HeikoKa/Wireless-3D-Touch-Probe-Sensor/media/pics/3D-Touch-Probe_Basestation.jpg

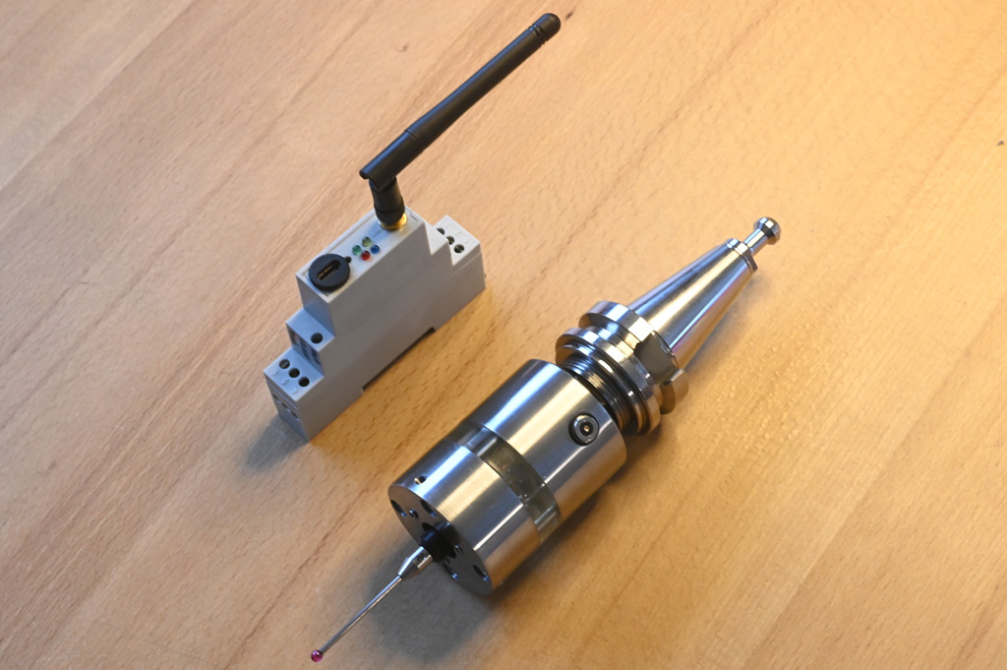
media/pics/3D-Touch-Probe_Basestation.jpg
