HeikoKa/Wireless-3D-Touch-Probe-Sensor/media/pics/3D-Touch-Probe_Loading.jpg

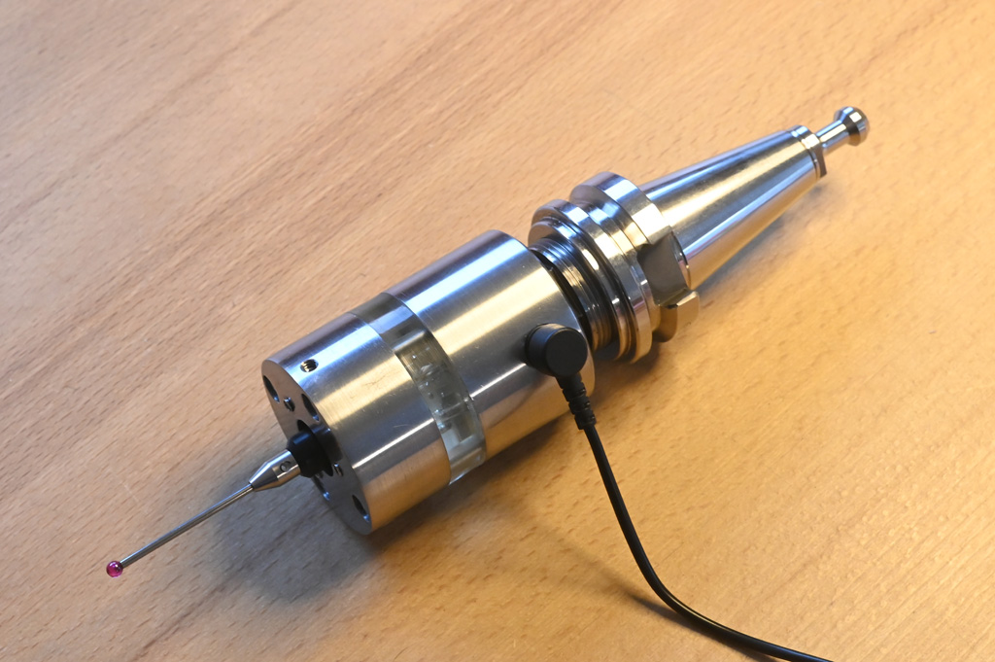
media/pics/3D-Touch-Probe_Loading.jpg
