HeikoKa/Wireless-3D-Touch-Probe-Sensor/media/pics/3D_Touch_Probe.jpg

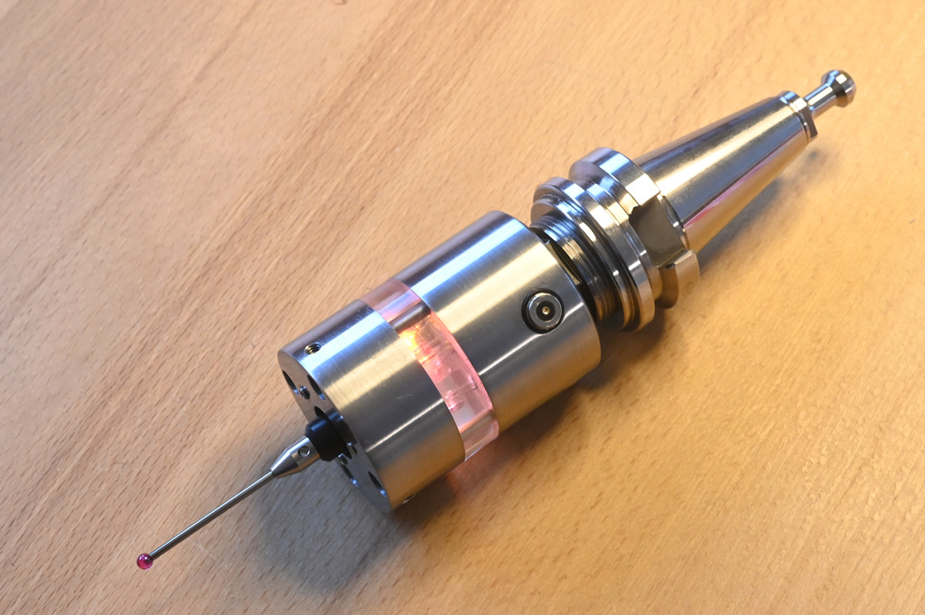
media/pics/3D_Touch_Probe.jpg
