HeikoKa/Wireless-3D-Touch-Probe-Sensor/media/pics/Basestation PCB/Basestation complete V1_0.jpg

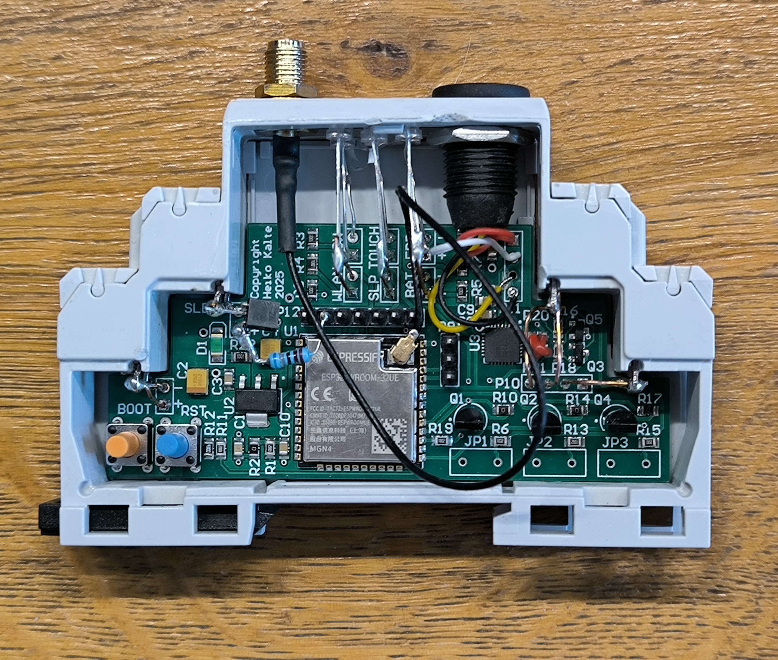
media/pics/Basestation PCB/Basestation complete V1_0.jpg
