HeikoKa/Wireless-3D-Touch-Probe-Sensor/media/pics/Basestation PCB/Basestation first Prototype.jpg

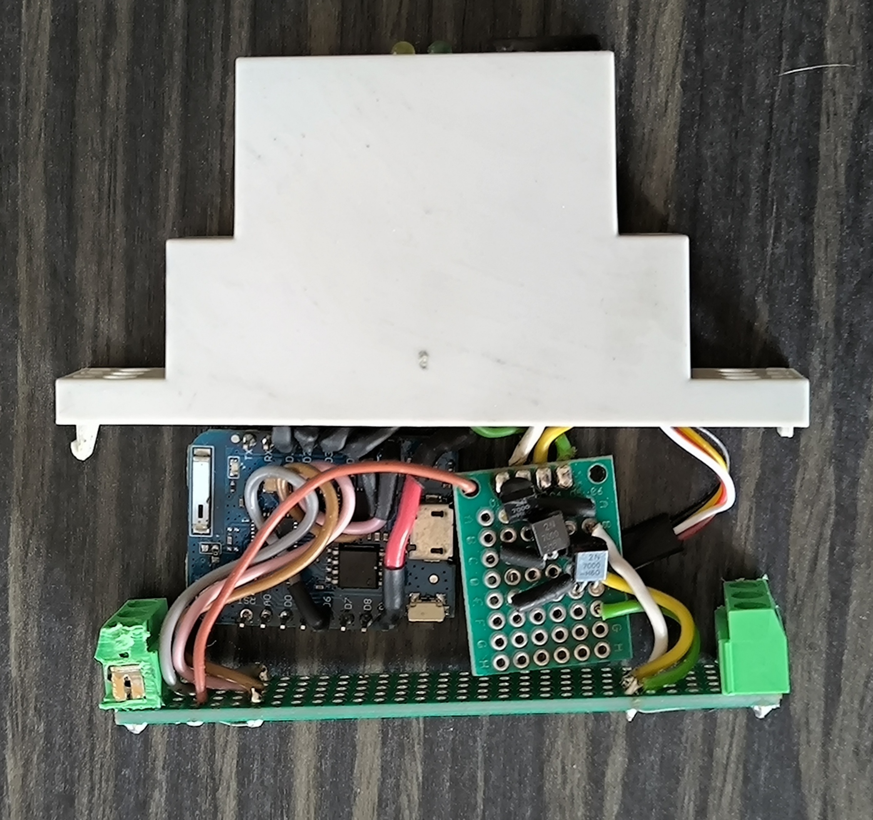
media/pics/Basestation PCB/Basestation first Prototype.jpg
