HeikoKa/Wireless-3D-Touch-Probe-Sensor/media/pics/Basestation PCB/Basestation PCB V2_0.jpg

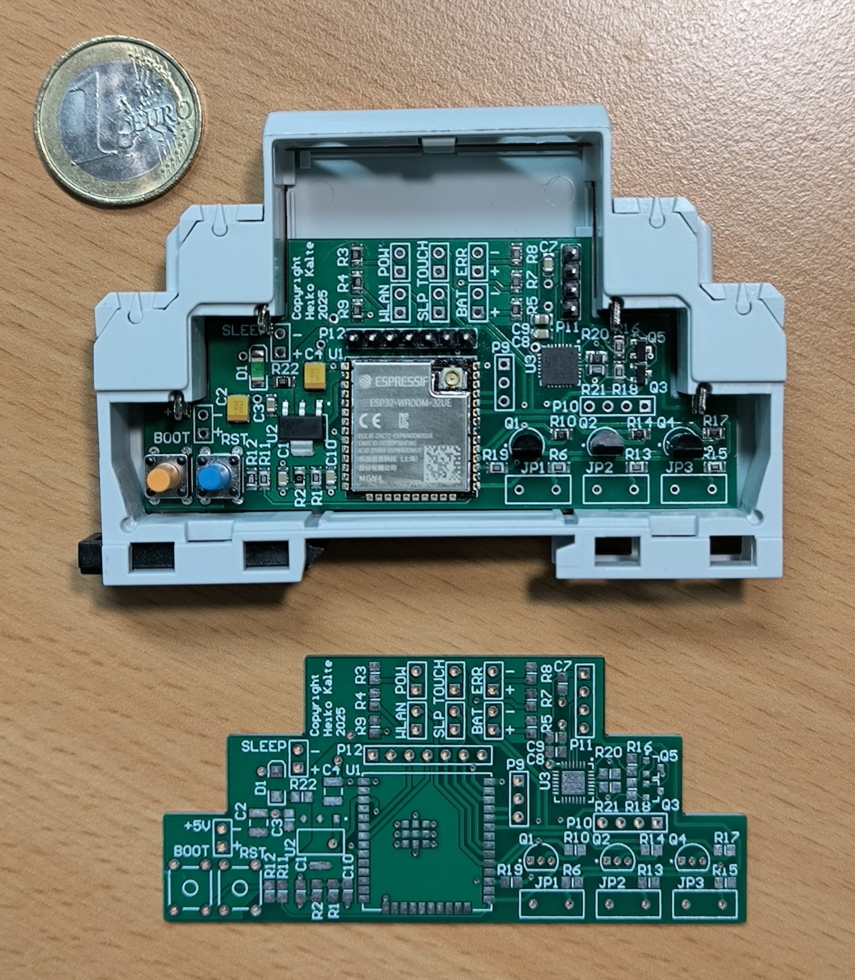
media/pics/Basestation PCB/Basestation PCB V2_0.jpg
