HeikoKa/Wireless-3D-Touch-Probe-Sensor/media/pics/Basestation.jpg

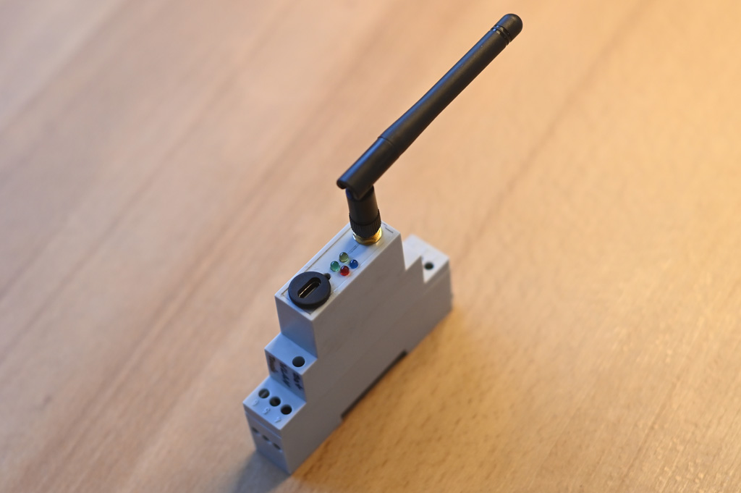
media/pics/Basestation.jpg
