HeikoKa/Wireless-3D-Touch-Probe-Sensor/media/pics/Electronics.jpg

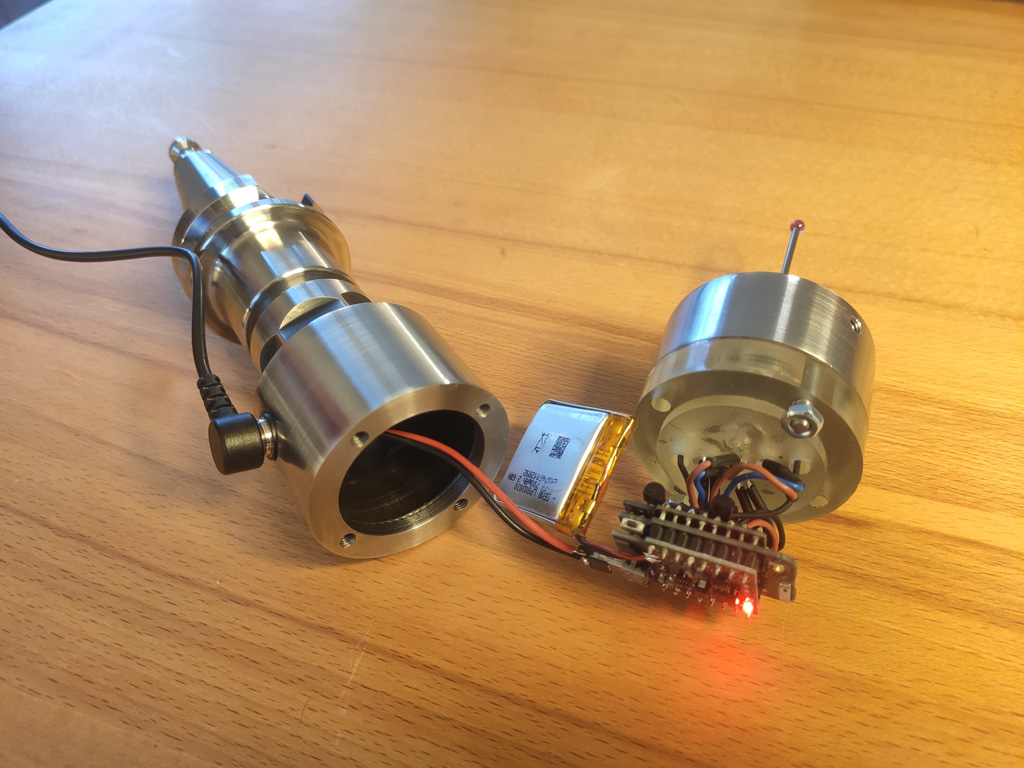
media/pics/Electronics.jpg
