HeikoKa/Wireless-3D-Touch-Probe-Sensor/media/pics/Grinding.jpg

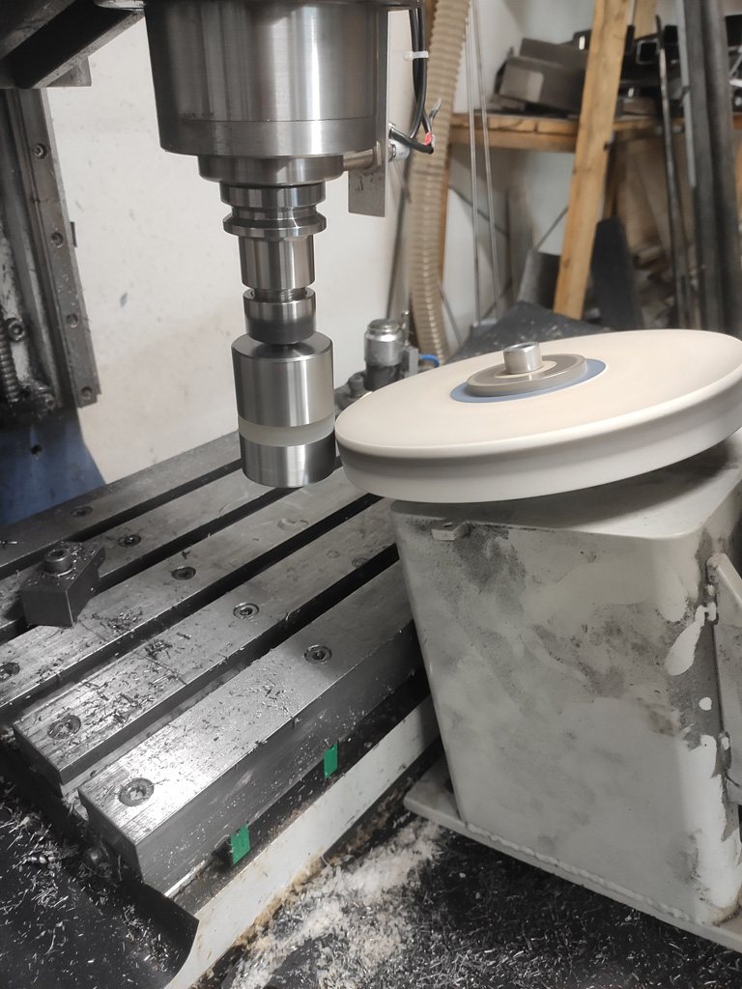
media/pics/Grinding.jpg
