HeikoKa/Wireless-3D-Touch-Probe-Sensor/media/pics/Machining_Bottom.jpg

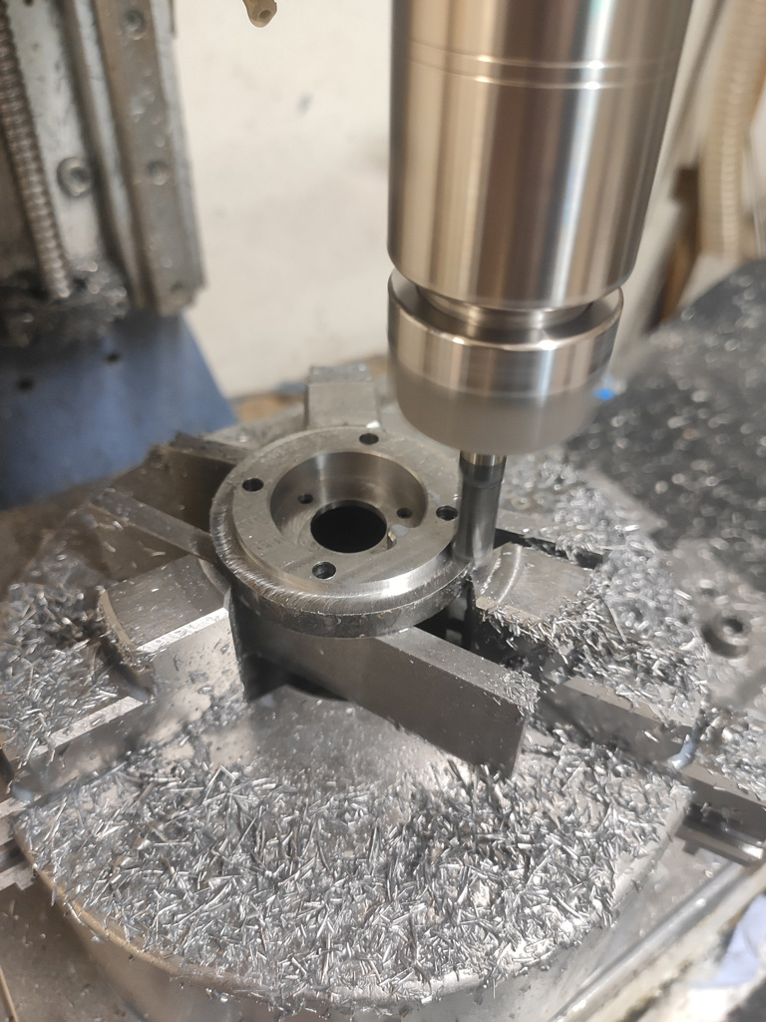
media/pics/Machining_Bottom.jpg
