HeikoKa/Wireless-3D-Touch-Probe-Sensor/media/pics/Machining_Epoxy.jpg

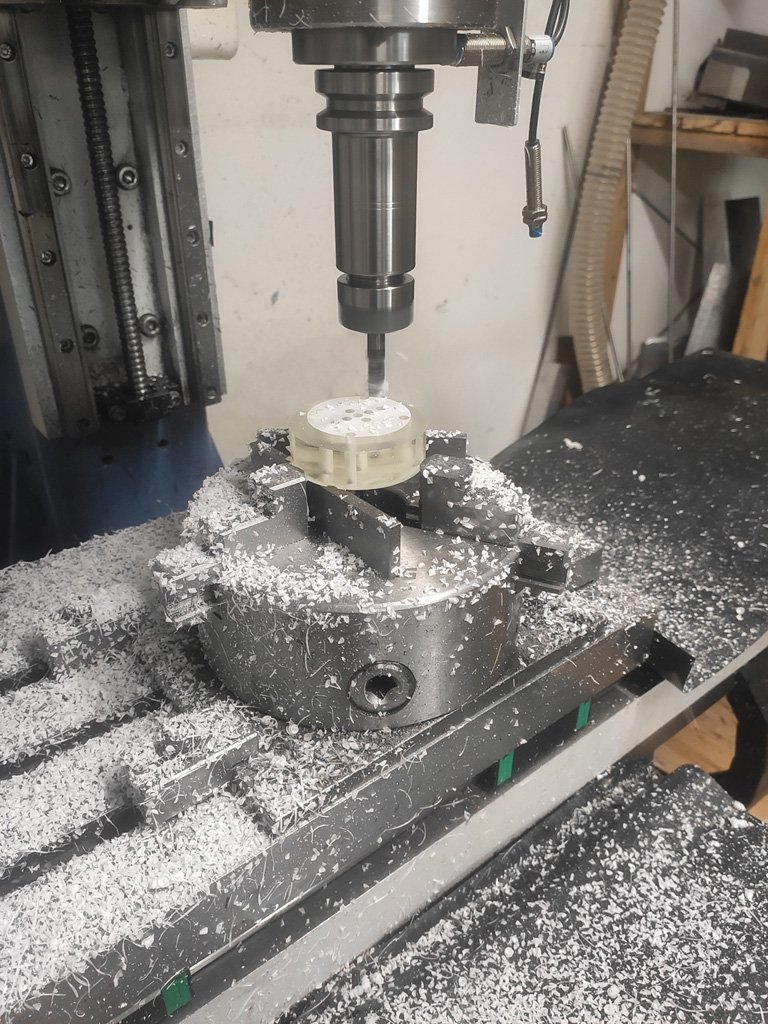
media/pics/Machining_Epoxy.jpg
