HeikoKa/Wireless-3D-Touch-Probe-Sensor/media/pics/MCU_Lipo.jpg

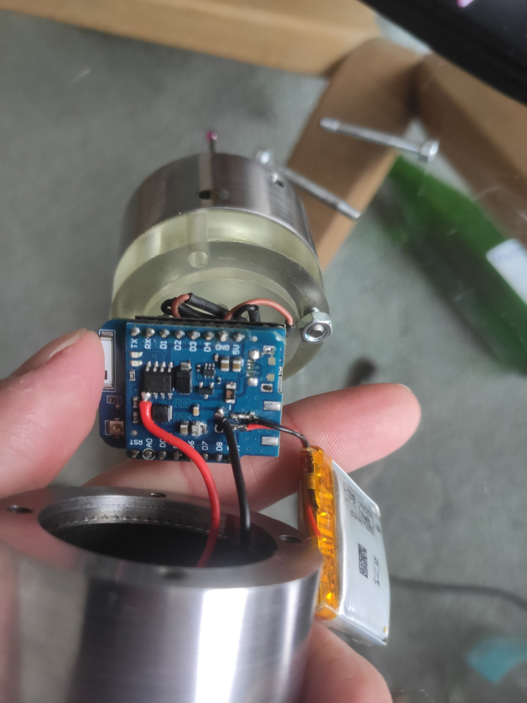
media/pics/MCU_Lipo.jpg
