HeikoKa/Wireless-3D-Touch-Probe-Sensor/media/pics/Sensor PCB/Sensor PCB V1_0 Backside Commented.jpg

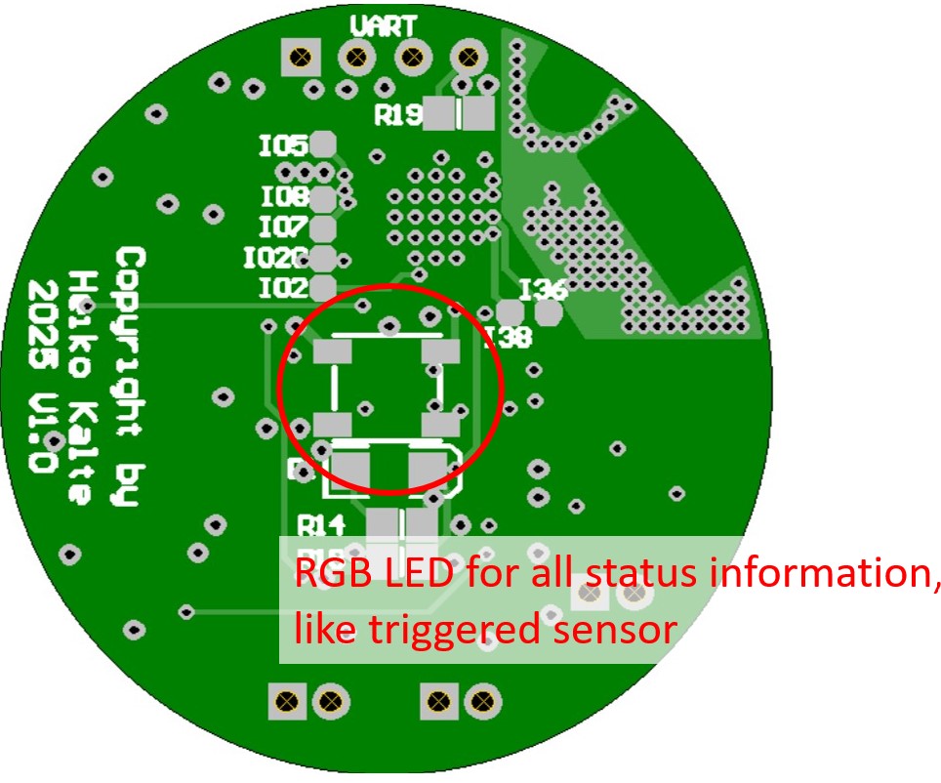
media/pics/Sensor PCB/Sensor PCB V1_0 Backside Commented.jpg
