HeikoKa/Wireless-3D-Touch-Probe-Sensor/media/pics/Transmit_Delay.jpg

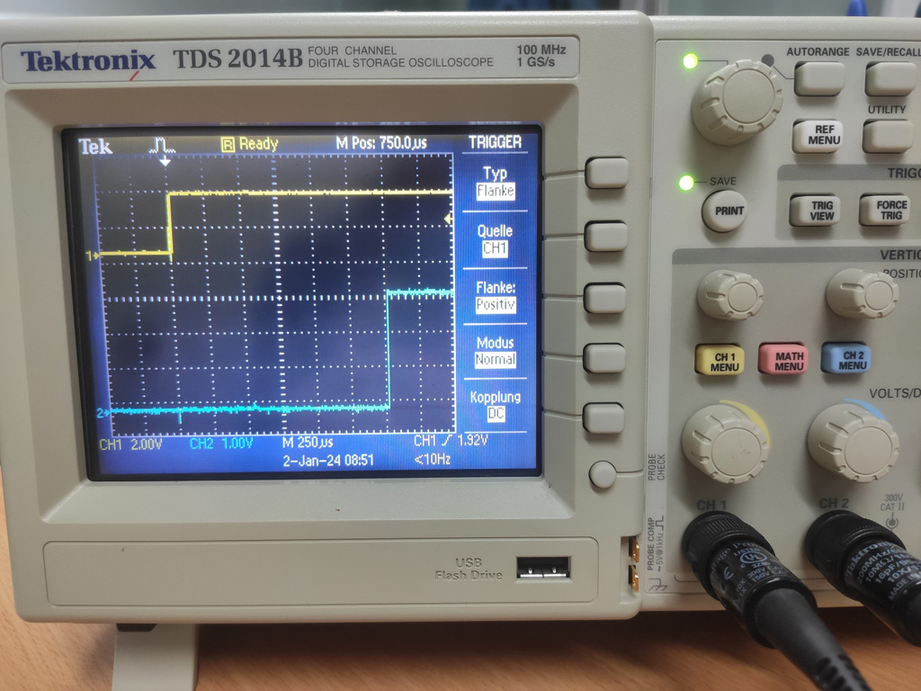
media/pics/Transmit_Delay.jpg
