HeikoKa/Wireless-3D-Touch-Probe-Sensor/media/pics/Webserver.jpg

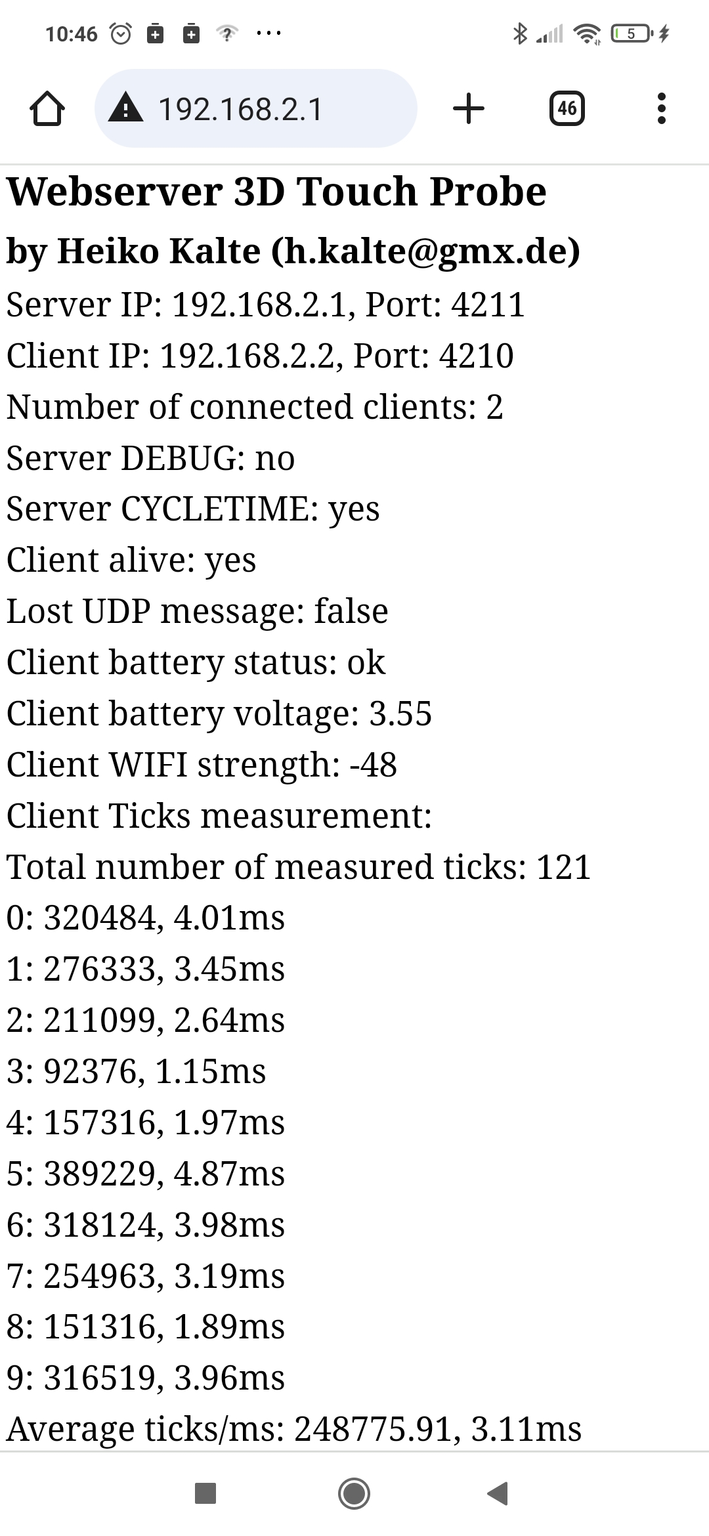
media/pics/Webserver.jpg
