HeikoKa/Wireless-3D-Touch-Probe-Sensor/src/3D-Header.h

/**  Header
  *   
  *  @author Heiko Kalte  
  *  @date 26.05.2025 
  * 
  *  @version 1.0.2
  */


//TODOs
//is NANOSEC_PER_TICK for ESP32 correct


#ifndef CNCSENSOR_H_
#define CNCSENSOR_H_

//## user defines start ##
//general defines
#define DEBUG                           // enable debug output via serial interface on client and server
#define DEBUG_SHOW_MEM_CPU_STATS         // show memory and cpu statistics
//#define VERBOSE                       // enable detailed debug Infos, only relevant with debug
//#define DEBUG_SHOW_CORE               // additional debug info on which cpu core the current function is running
//#define DEBUG_SHOW_ALL_TRANSMISSIONS  // show all wifi transmissions during DEBUG
//#define CYCLETIME                     // enable measuring the round trip delay from client to server back to client

// server/basestation specific defines
#define SERVER_HW_REVISION_3_0          // set this define if basestation/server is hardware revision 3.0 or later
#define WEBSERVER                     // enable webserver

// client specific defines
#define CLIENT_HW_REVISION_2_0          // set this define if client is hardware PCB revision 2.0 or later
//#define SHOW_STATE_COLORS             // if enabled at the startup of the client all state colors are shown one after the other
//## user defines end ##

#include "IPAddress.h"

namespace CncSensor{

  //RGB Colors                                //red                    , green                  , blue
  #define           POWER_COLOR                 CLIENT_RGB_BRIGHTNESS  , CLIENT_RGB_BRIGHTNESS  , CLIENT_RGB_BRIGHTNESS    //white  (255, 255, 255)
  #define           CHARGE_COLOR                0                      , CLIENT_RGB_BRIGHTNESS  , 0                        //green  (0  , 255,   0)
  #define           TOUCH_COLOR                 0                      , 0                      , CLIENT_RGB_BRIGHTNESS    //blue   (0  ,   0, 255)
  #define           WLAN_COLOR                  CLIENT_RGB_BRIGHTNESS  , CLIENT_RGB_BRIGHTNESS  , CLIENT_RGB_BRIGHTNESS    //white  (255, 255, 255)
  #define           RSSI_ERROR_COLOR            CLIENT_RGB_BRIGHTNESS  , 0                      , CLIENT_RGB_BRIGHTNESS    //magenta(255,   0, 255)
  #define           BATTERY_ERROR_COLOR         CLIENT_RGB_BRIGHTNESS  , 0                      , 0                        //red    (255,   0,   0)
  #define           WIFI_ERROR_COLOR            CLIENT_RGB_BRIGHTNESS  , CLIENT_RGB_BRIGHTNESS  , 0                        //yellow (255, 255,   0)
  #define           ALIVE_ERRROR_COLOR          CLIENT_RGB_BRIGHTNESS  , CLIENT_RGB_BRIGHTNESS/2, 0                        //orange (255, 127,   0)

  //datatypes
  enum fadingType  {NONE, UP, DOWN};
  
  //Version type def
  struct versionType{
    char  * swVersionString          = NULL;                  // Sw version as a string
    uint8_t mayorHwVersion           = 0;                     // mayor hardware PCB version
    uint8_t mayorSwVersion           = 0;                     // mayor software version
    uint8_t minorSwVersion           = 0;                     // minor software version
    uint8_t maintSwVersion           = 0;                     // maintenance software version
    bool    versionOk                = false;                 // is hardware mayor version at least the same as software mayor version
  };

  //general consts
  const int          BAUD_RATE                   = 9600;                  // Baud rate for serial outputs/debug
  const char*        SSID                        = "3D-Touch-WIFI";       // WLAN network name to search for when connecting to the webserver
  const char*        password                    = "123456789";           // WLAN password

  //server consts
  const char*        SERVER_SLEEP_MSG            = "sleep";               // UDP message from server to client to send client asleep
  const char*        SERVER_HELLO_MSG            = "hello";               // UDP message from server to client to say hello
  const char*        SERVER_REPLY_MSG            = "reply";               // UDP message from server to client to reply to hello msg
  const char*        SERVER_ALIVE_MSG            = "alive";               // UDP message from server to show server is alive  
  const int          CLIENT_ALIVE_CNT_MAX        = 2;                     // maximum client alive counter value
  const long         WIFI_RSSI_REPORT_LEVEL      = -85;                   // RSSI level, WLAN signal strength e.g. -40 is better -70 is worse (best was ~-30)
  const int          SERVER_TICKS_ARRAY_SIZE     = 10;                    // Array Size of measured ticks
  const bool         SERVER_SLEEP_IN_POLARITY    = true;                  // Invert SLEEP Input polarity. False means high input send sensor aleep. Truee means low input send sensor aleep (be aware that the input is inverted by a transistor, behaviour will be inverted without an external transistor)
  const bool         SERVER_WLAN_OUT_POLARITY    = true;                  // (works only with server PCB version 3 or later) invert polarity of WLAN output, false means high represents active output, true inverts output and low is active
  const bool         SERVER_TOUCH_OUT_POLARITY   = true;                  // (works only with server PCB version 3 or later) invert polarity of TOUCH output, false means high represents active output, true inverts output and low is active
  const bool         SERVER_ERROR_OUT_POLARITY   = true;                  // (works only with server PCB version 3 or later) invert polarity of ERROR output, false means high represents active output, true inverts output and low is active
  const bool         SERVER_BAT_ALM_OUT_POLARITY = true;                  // (works only with server PCB version 3 or later) invert polarity of BAT ALARM output, false means high represents active output, true inverts output and low is active
  const float        NANOSEC_PER_TICK            = 12.5;                  // ## Attention this value has not been verified for the ESP32 ##

  //client consts
  const char*        CLIENT_HELLO_MSG        = "hello";                   // UDP message from client to server to say hello
  const char*        CLIENT_REPLY_MSG        = "reply";                   // UDP message from client to server to reply to hello msg
  const char*        CLIENT_TOUCH_HIGH_MSG   = "high";                    // UDP message from client if 3D touch probe is high
  const char*        CLIENT_TOUCH_LOW_MSG    = "low";                     // UDP message from client if 3D touch probe is low
  const char*        CLIENT_ALIVE_MSG        = "alive";                   // UDP message from client alive
  const char*        CLIENT_RSSI_MSG         = "rssi";                    // UDP message from client with rssi (WLAN signal strength)
  const char*        CLIENT_CYCLE_MSG        = "CYC:";                    // UDP message from client to server to transmit the last measured cycle time ticks
  const char*        CLIENT_INFO_MSG         = "INFO:";                   // UDP message from client to server with infos about the client
  const int          SERVER_AQUN_CNT_MAX     = 25000;                     // number of loop cycles before the server must acknowledge the high/low messages
  const int          TOUCH_PIN_DEBOUNCE      = 700;                       // debounce time in µs for software touch input pin
  const uint8_t      CLIENT_RGB_BRIGHTNESS   = 20;                        // brightness of the RGB LED (max 255). Product of CLIENT_RGB_BRIGHTNESS x RGB_FADE_SPEED = Fading Time at start and end
  const bool         CLIENT_TOUCH_POLARITY   = true;                      // invert sensor touch input 
  const uint8_t      TRANSMISSION_RETRY_MAX  = 3;                         // maximum wifi transmission retrys before an transmission error is reported
  //client sleep and awake consts
  const bool         NO_SLEEP_WHILE_CHARGING = false;                     // prevent sleeping during battery loading, e.g. to keep status LED on to see is charging finished. SLEEP_DURING_CHARGING mut not be true at the same time
  const bool         SLEEP_DURING_CHARGING   = false;                     // fall asleep when charging voltage is applied (need not necessary charging), helpfull e.g. in case of a charger in the toolchanger magazine. NO_SLEEP_WHILE_CHARGING must not be true at the same time
  const bool         AUTO_SLEEP_TIMER_ENABLE = false;                     // enables/disables a timeout counter that sends the client asleep after a certain period of time of no touching (see also SLEEP_NO_TOUCH_CYCLES)
  const int          AUTO_SLEEP_TIMER_CYCLES = 30;                        // timeout service cycles to send the client asleep after no touching event (timeout function must be enabled by SLEEP_NO_TOUCH_TIMEOUT, has also a relationship to parameter SERVICE_INTERVALL)
  const int          SERVER_ALIVE_CNT_MAX    = 2;                         // maximum server alive counter value, try to reconnect
  const int          SERVER_ALIVE_CNT_DEAD   = 3;                         // maximum server alive counter value, server seems to be dead and go to sleep
  const bool         CLIENT_ALLOW_LED_FADING = true;                      // allow fading LED at startup and sleep. Leads to longer startup time, but looks nice.
  const uint8_t      CLIENT_RGB_FADE_SPEED   = 100;                       // speed for fading out the LED brightness when going to sleep. Set as delay, smaller value faster fading
  
  //client and server consts
  const uint32_t     SERVICE_INTERVALL_ESP32 = 15000000;                  // ESP32 Time in 1MHz ticks between service interrupt calls (20000000 = 20sec)
  const int          UDP_PACKET_MAX_SIZE     = 128;                       // UDP buffer size
  const uint8_t      SLOW_BLINK              = 1000;                      // delay for slow blinking LED
  const uint8_t      FAST_BLINK              = 500;                       // delay for fast blinking LED
  const uint8_t      WLAN_INIT_PAUSE         = 100;                       // Pause length during WLAN initiation

  //IP addresses
  IPAddress         serverIpAddr(192,168,  2,1);                          // local IP address of server and webserver ip address if enabled
  IPAddress         clientIpAddr(192,168,  2,2);                          // local IP address of client
  IPAddress         gateway     (192,168,  2,0);                          // gateway of server, need to have a value, but does not exist
  IPAddress         subnet      (255,255,255,0);                          // subnet mask of WLAN network

  //Global variables
  unsigned int      serverUdpPort            = 4211;                      // server port
  unsigned int      clientUdpPort            = 4210;                      // client port

  //Battery consts
  const float       BAT_LOW_VOLT             = 3.7;                       // battery voltage below this, is indicated as low battery state
  const float       BAT_CRIT_VOLT            = 3.6;                       // battery voltage below this, is indicated as critical battery state
  const float       BAT_CORRECTION           = 0.2;                       // use this correction for the battery voltage if analog measure differs from multimeter measure
  const char*       CLIENT_BAT_OK_MSG        = "bat ok";                  // UDP message for battery voltage is ok
  const int         CLIENT_BAT_OK            = 1;                         // internal coding for battery is ok
  const char*       CLIENT_BAT_LOW_MSG       = "bat low";                 // UDP message for battery is low 
  const int         CLIENT_BAT_LOW           = 2;                         // internal coding for battery is low
  const char*       CLIENT_BAT_CRITICAL_MSG  = "bat critical";            // UDP message for battery is critical
  const int         CLIENT_BAT_CRITICAL      = 3;                         // internal coding for battery is critical

  // Server specific LEDs
  #ifdef SERVER_HW_REVISION_3_0
    // Sensor Basestation hardware version 3.0 distinguishs between outputs for LED and output for CNC controller
    const uint8_t     SERVER_POWER_LED        = 2;                      // Attention: Power LED, is not used  before Basestation PCB revision 5.0
    const uint8_t     SERVER_WLAN_LED         = 21;                     // LED to inducate the current WLAN state
    const uint8_t     SERVER_TOUCH_LED        = 32;                     // LED to indicate a Touch of the 3D sensor
    const uint8_t     SERVER_ERROR_LED        = 19;                     // Error output that can e.g tell the cnc controller to stop
    const uint8_t     SERVER_SLEEP_IN         = 33;                     // Input pin for the CNC controller to indicate that the slave/sensor can go to sleep
    const uint8_t     SERVER_SLEEP_LED        = 22;                     // Sleep output LED, indicates that the server/Basestation request the sensor to go asleep
    const uint8_t     SERVER_BAT_ALM_LED      = 23;                     // Client battery status
    // additional channels for hardware revision 3.0 or later
    const uint8_t     SERVER_WLAN_OUT         = 4;                      // LED to indicate the current WLAN state for the CNC controller
    const uint8_t     SERVER_TOUCH_OUT        = 17;                     // LED to indicate a Touch of the 3D sensor for the CNC controller
    const uint8_t     SERVER_ERROR_OUT        = 5;                      // general error output that can hold the cnc controller
    const uint8_t     SERVER_BAT_ALM_OUT      = 18;                     // Low battery output for the CNC controllerthat
  #else //SERVER_HW_REVISION_3_0
    //Following Data is valid for the Sensor Basestation PCB hardware version 1.0 and 2.0
    //ESP32 Server specific LEDs  
    //const uint8_t     SERVER_POWER_LED        = 22;                     // Attention: Power LED, is not used  before Basestation PCB revision 5.0
    const uint8_t     SERVER_WLAN_LED         = 5;                      // LED to inducate the current WLAN state
    const uint8_t     SERVER_TOUCH_LED        = 17;                     // LED to indicate a touch of the 3D sense
    const uint8_t     SERVER_ERROR_LED        = 23;                     // ERROR output that can hold the cnc controller, e.g.critical battery or no more alive msg from client
    const uint8_t     SERVER_SLEEP_IN         = 33;                     // Input pin for the CNC controller to indicate that the slave can go to sleep
    const uint8_t     SERVER_SLEEP_LED        = 19;                     // Sleep Output for LED
    const uint8_t     SERVER_BAT_ALM_LED      = 21;                     // server battery is low
  #endif //SERVER_HW_REVISION_3_0
  const uint8_t     SERVER_HW_REVISION_0      = 25;                     // The basestation/server hardware PCB revision is coded into 3 input bit, this is bit 0
  const uint8_t     SERVER_HW_REVISION_1      = 26;                     // The basestation/server hardware PCB revision is coded into 3 input bit, this is bit 1
  const uint8_t     SERVER_HW_REVISION_2      = 27;                     // The basestation/server hardware PCB revision is coded into 3 input bit, this is bit 2

  //Client specific LEDs
  const uint8_t     CLIENT_RGB_LED_OUT          = 27;                   // client rgb led instead of multiple leds
  const uint8_t     CLIENT_TOUCH_IN             = 33;                   // digital input pin to listen
  const uint8_t     CLIENT_SLEEP_OUT            = 4;                    // controls external sleep hardware
  const uint8_t     CLIENT_ANALOG_CHANNEL       = 38;                   // Analog In channel for reading the battery voltage
  const uint8_t     CLIENT_CHARGE_VOLTAGE_IN    = 32;                   // Input for battery charging voltage. Battery charging voltage is applied, battery is either charging or not (if already full). Without extra PCB wireing available from PCB version 4.
  const uint8_t     CLIENT_CHARGE_IN            = 25;                   // Input for battery charging. Battery charging voltage is applied and the battery is currently charging
  const uint8_t     CLIENT_HW_REVISION_0        = 19;                   // (Supported by client PCB version 2.0 and later) The client hardware PCB revision is coded into 3 input bit, this is bit 0
  const uint8_t     CLIENT_HW_REVISION_1        = 22;                   // (Supported by client PCB version 2.0 and later)The client hardware PCB revision is coded into 3 input bit, this is bit 1
  const uint8_t     CLIENT_HW_REVISION_2        = 21;                   // (Supported by client PCB version 2.0 and later)The client hardware PCB revision is coded into 3 input bit, this is bit 2
}  // namespace CncSensor
#endif
