HeikoKa/Wireless-3D-Touch-Probe-Sensor/(commit log)

2024-04-21 Fixed problem with tick array
    [3D-Server.ino]
2024-04-21 Another fix with the ticks array
    [3D-Server.ino]
2024-11-29 Sleep hardware changes
    Changed from deepsleep() to external hardware switching on and off the power.
2024-11-29 Changed polarity of sleep pin
    Changed polarity of sleep pin
2025-01-11 Total makeover and running ESP32
    Neu Basestation hardware works and ESP32 Client as well
2025-01-17 Works with any ESP8266/ESP32 Combi
2025-02-02 Udates on picture and Code
    Updated current status on the PCB development and many changes on the code.
2025-02-08 Hardware PCB Version 3.0 support
    New outputs to separate LED and CNC controller outputs and support of Hardware PCB revision in web server.
2025-02-09 LED blinking and all comments updated
2025-02-09 Hardware Revision for client
    Additionaly the channel numbers from the client pcb 1.0 were added.
2025-02-15 Server PCB 2.0 and Client PCB1.0 supported
    First version to support Server PCB 2.0 and Client PCB 1.0 supported. ESP8266 is not tested anymore and will be removed in the future.
2025-02-16 Changed Analog In Channel
    ESP32 can not use some Analog in together with Wifi. Needed to channel number.
2025-03-15 Support new hardware/PCB versions
    This version supports the new server hardware/PCB version 3.0 and the client hardware/PCB version 2.0.
2025-03-25 Added Arduino board settings
2025-03-27 WLAN Strength and Bat Voltage is averaged
2025-03-28 New Feature Going to sleep while charging
2025-04-03 Supporting check for charging voltage
2025-04-05 Improved charging logic
2025-04-09 Fixes an error message of the hardware timer
    [3D-Client.ino, 3D-Header.h, 3D-Server.ino]
2025-04-09 Added info about the esp32 board package version
